drbig/irpanel/irpanel.jpg

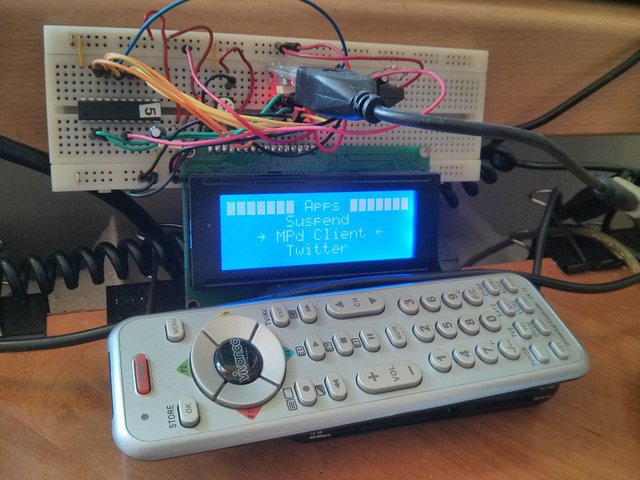
irpanel.jpg
