drbig/irpanel/cad/case.dxf

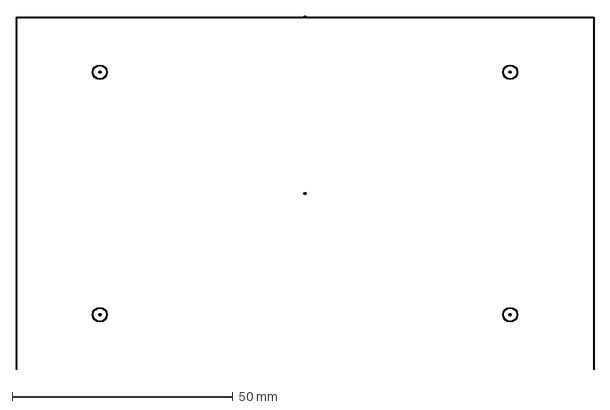
[picture p2: CAD file, 2014-06-19]
cad/case.dxf
131.0 x 80.2 mm
