drbig/irpanel/cad/case.pdf

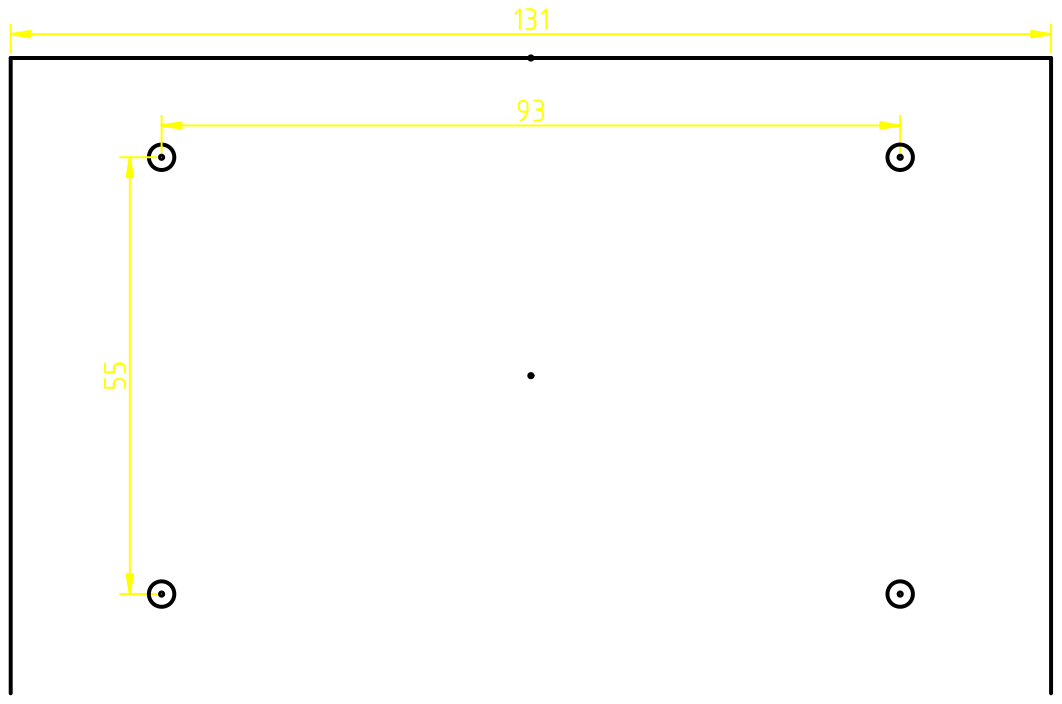
[picture p3: page 1]
