drbig/irpanel/cad/irpanel.pdf

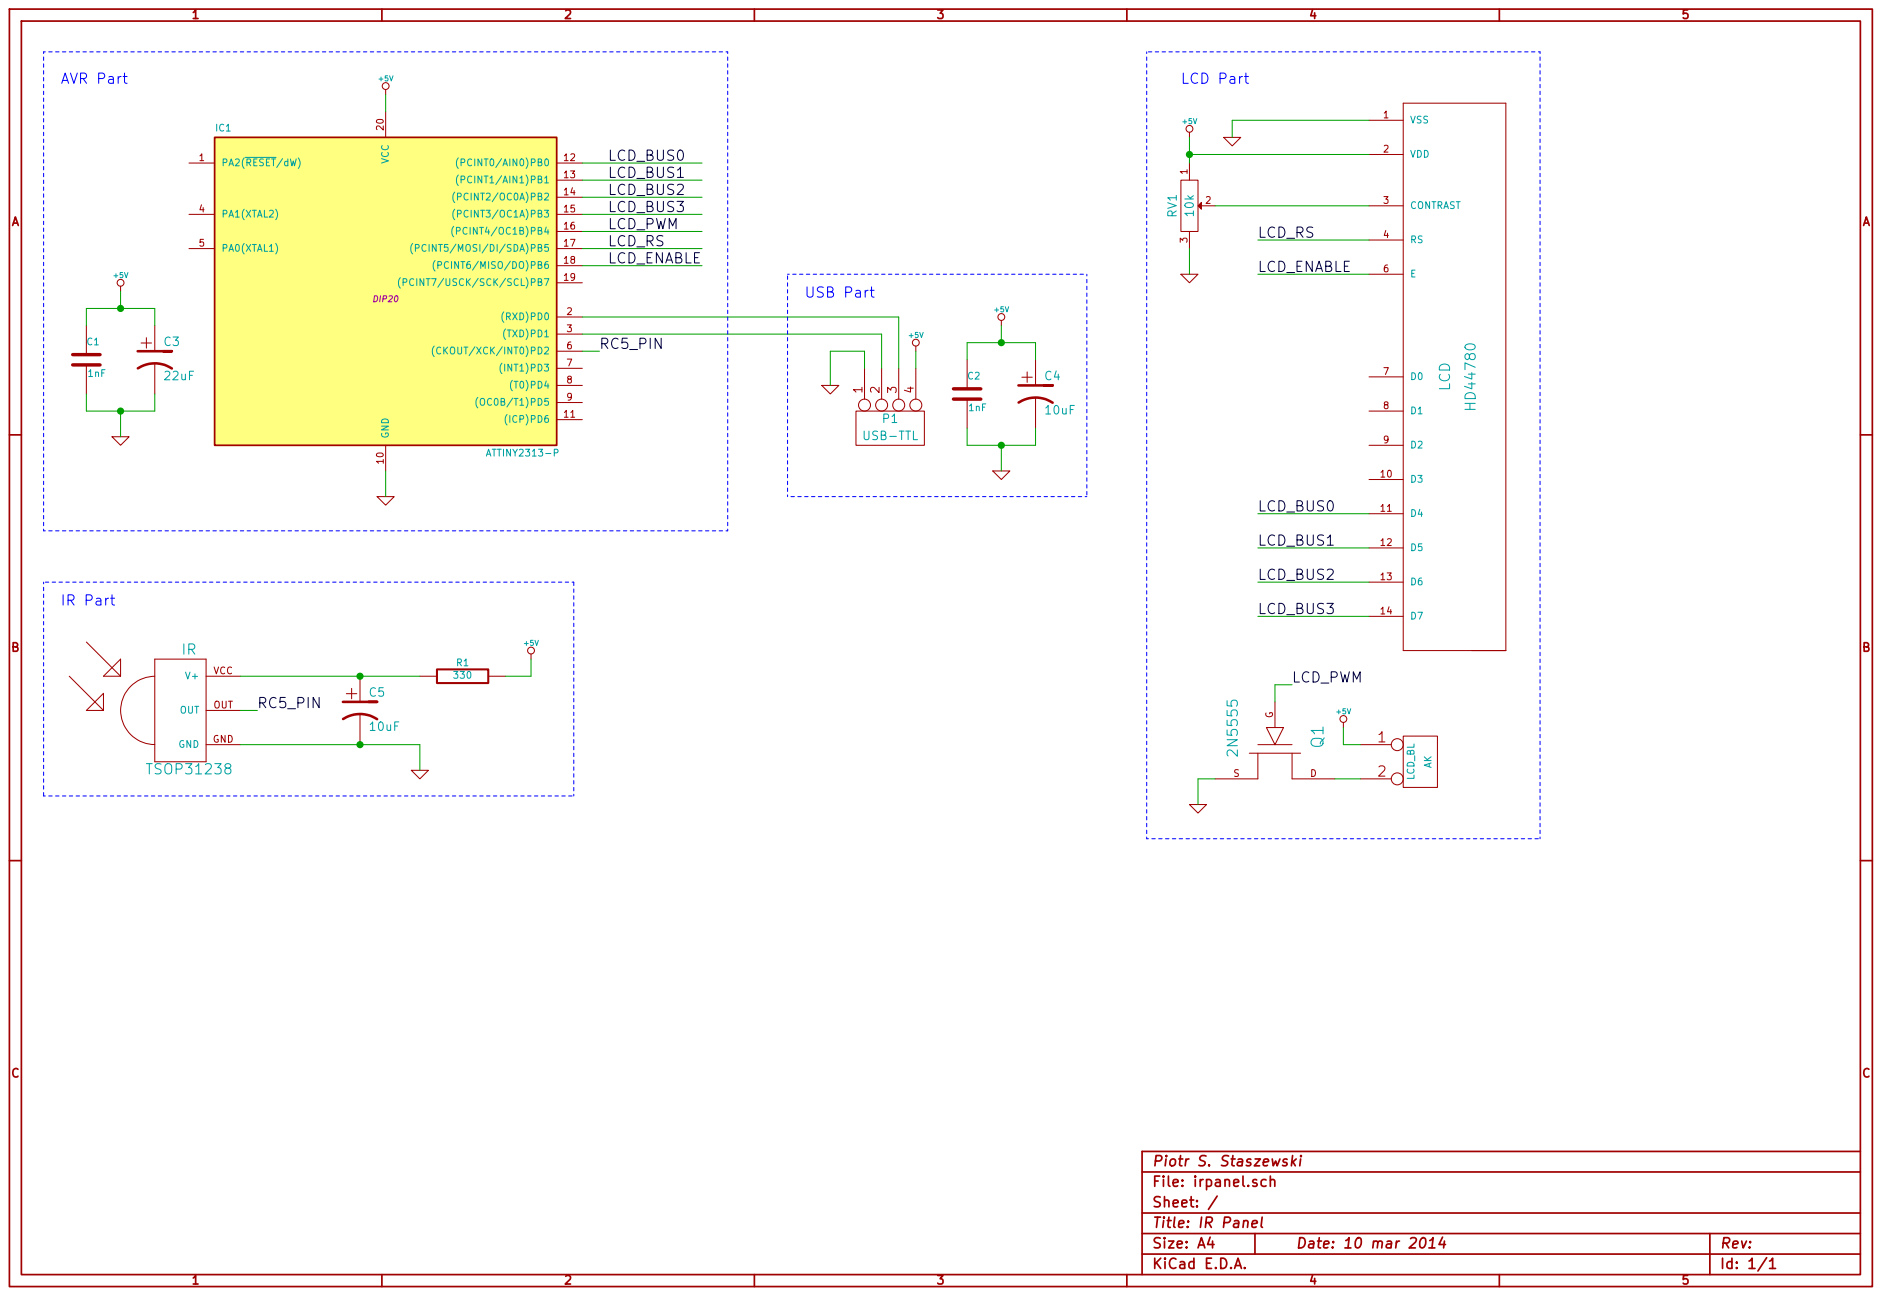
[picture p4: page 1]

Piotr S. Staszewski
Id: 1/1 Title: IR Panel File: irpanel.sch
Sheet: /
