drbig/irpanel/cad/irpanel.sch

## KiCad design cad/irpanel.sch (2014-04-28)

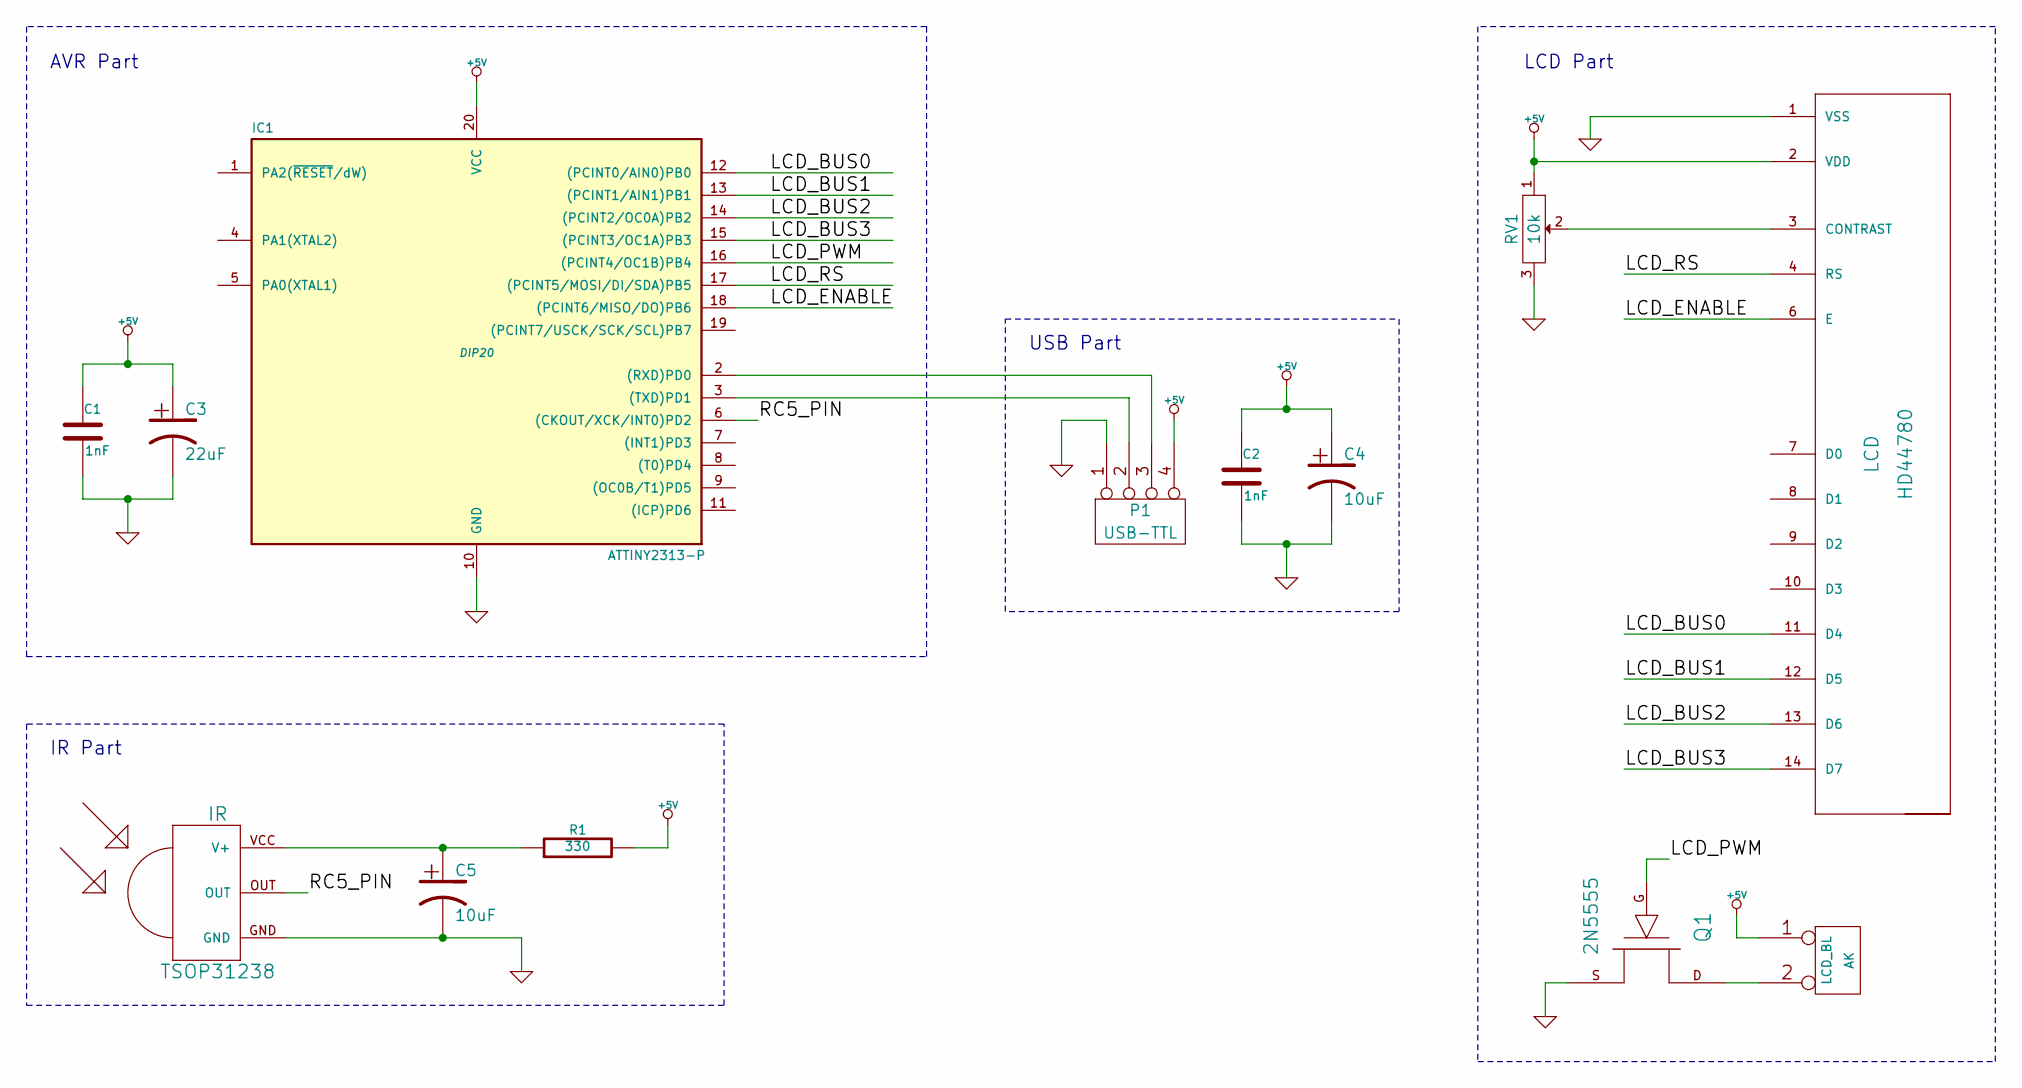
[picture p5: schematic irpanel.sch]

Parts:
C1, C2: 1nF
C3: 22uF
C4, C5: 10uF
IC1: ATTINY2313-P; DIP20
IR: TSOP31238
LCD: HD44780
LCD_BL: AK
P1: USB-TTL
Q1: 2N5555
R1: 330
RV1: 10k

Connections:
+5V: C1.1, C2.1, C3.1, C4.1, IC1.20 (VCC), LCD.2 (VDD), LCD_BL.1, P1.4, R1.2, RV1.1
GND: C1.2, C2.2, C3.2, C4.2, C5.2, IC1.10 (GND), IR.GND, LCD.1 (VSS), P1.1, Q1.S, RV1.3
LCD_BUS0: IC1.12 ((PCINT0/AIN0)PB0), LCD.11 (D4)
LCD_BUS1: IC1.13 ((PCINT1/AIN1)PB1), LCD.12 (D5)
LCD_BUS2: IC1.14 ((PCINT2/OC0A)PB2), LCD.13 (D6)
LCD_BUS3: IC1.15 ((PCINT3/OC1A)PB3), LCD.14 (D7)
LCD_ENABLE: IC1.18 ((PCINT6/MISO/DO)PB6), LCD.6 (E)
LCD_PWM: IC1.16 ((PCINT4/OC1B)PB4), Q1.G
LCD_RS: IC1.17 ((PCINT5/MOSI/DI/SDA)PB5), LCD.4 (RS)
unnamed: C5.1, IR.VCC (V+), R1.1
unnamed: IC1.2 ((RXD)PD0), P1.3
unnamed: IC1.3 ((TXD)PD1), P1.2
unnamed: LCD.3 (CONTRAST), RV1.2
unnamed: LCD_BL.2 (PM), Q1.D
RC5_PIN: IC1.6 ((CKOUT/XCK/INT0)PD2), IR.OUT

Notes on the sheet:
AVR Part
USB Part
LCD Part
IR Part
