drbig/irpanel/(commit log)

2014-04-28 Initial public commit
    [irpanel.sch, keys.csv]
2014-06-19 Casing CAD files
    Minimal QCad drawing for LCD module placement. Refer to your LCD
    module datasheet to see if the hole placements are correct.
    [case.dxf]
